safoankhan-rgb/nothing/01/docs/assets/01-light.png

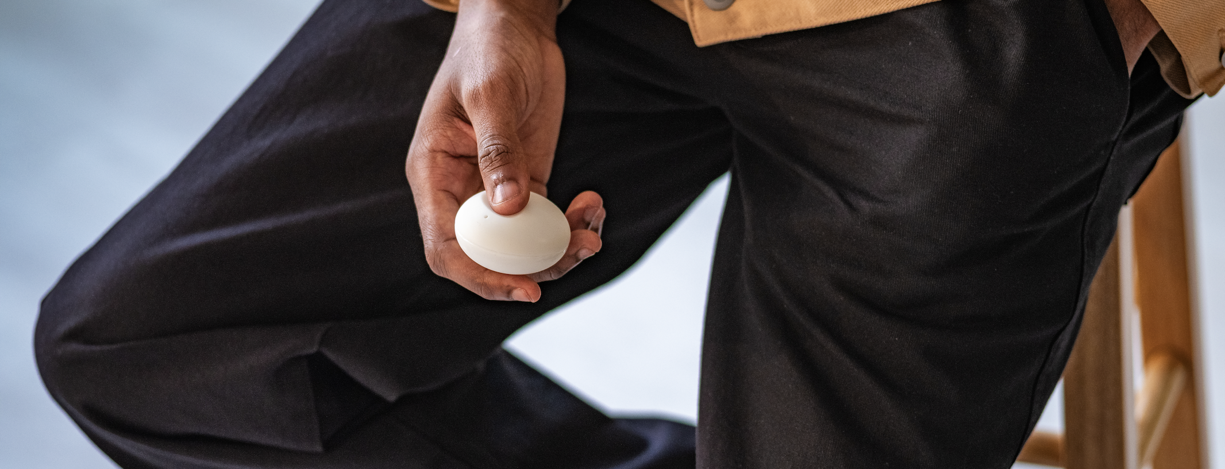
01/docs/assets/01-light.png
