safoankhan-rgb/nothing/01/docs/assets/app.png

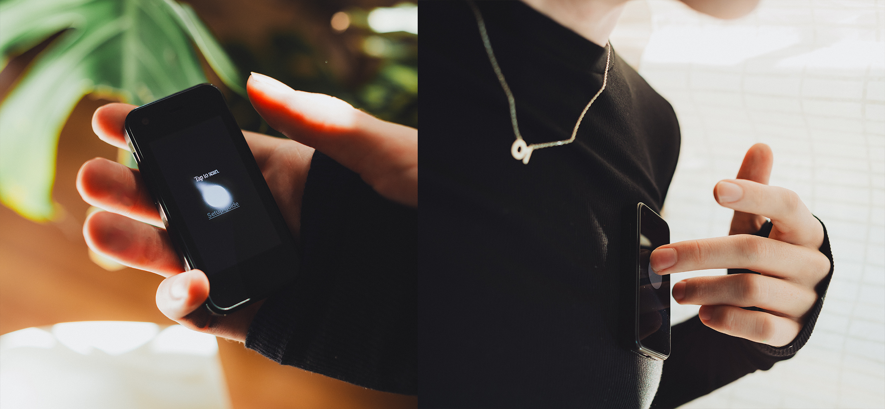
01/docs/assets/app.png
