safoankhan-rgb/nothing/01/docs/assets/AsyncTCP by dvarrel.png

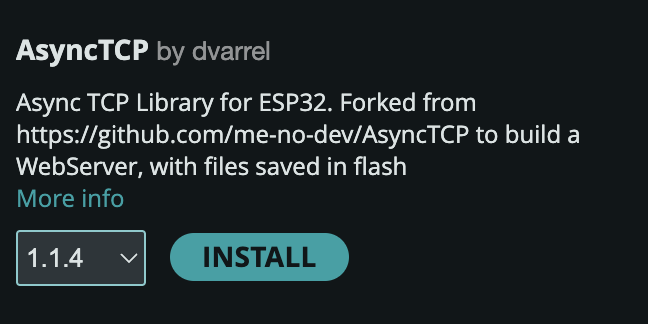
01/docs/assets/AsyncTCP by dvarrel.png
