safoankhan-rgb/nothing/01/docs/assets/boards-manager.png

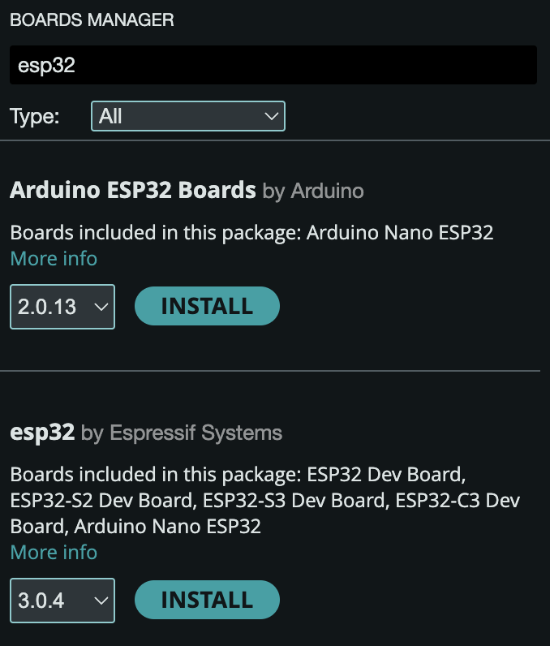
01/docs/assets/boards-manager.png
