safoankhan-rgb/nothing/01/docs/assets/connect_usb.jpeg

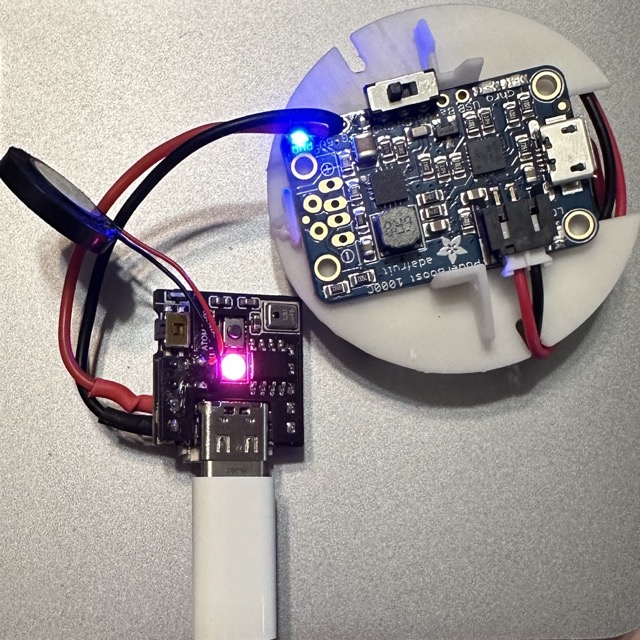
01/docs/assets/connect_usb.jpeg
