safoankhan-rgb/nothing/01/docs/assets/copy-client.png

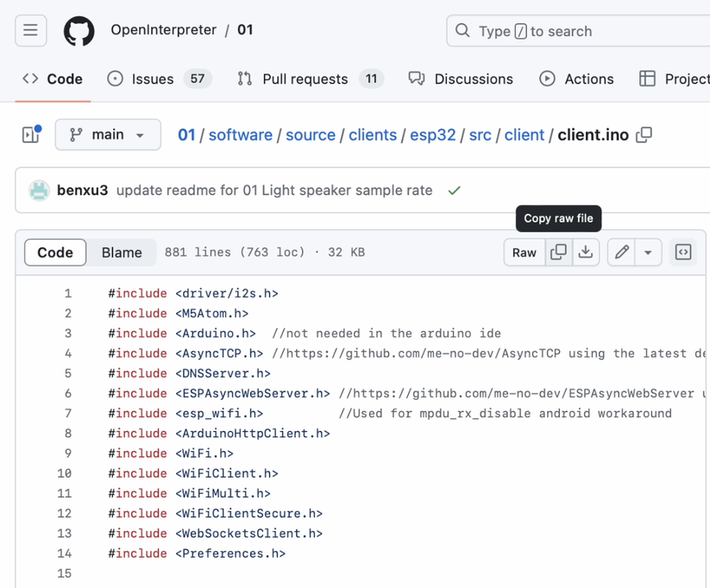
01/docs/assets/copy-client.png
