safoankhan-rgb/nothing/01/docs/assets/ESPAsyncWebServer by lacamera.png

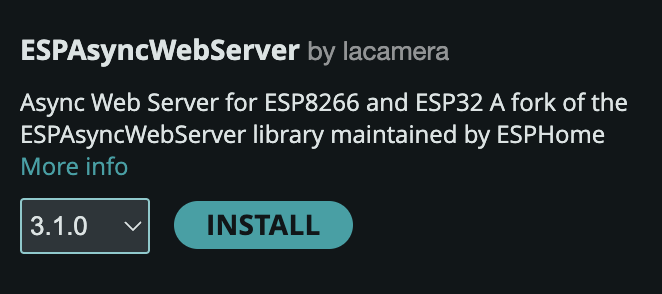
01/docs/assets/ESPAsyncWebServer by lacamera.png
