safoankhan-rgb/nothing/01/docs/assets/hardcode-wifi-pass-server.png

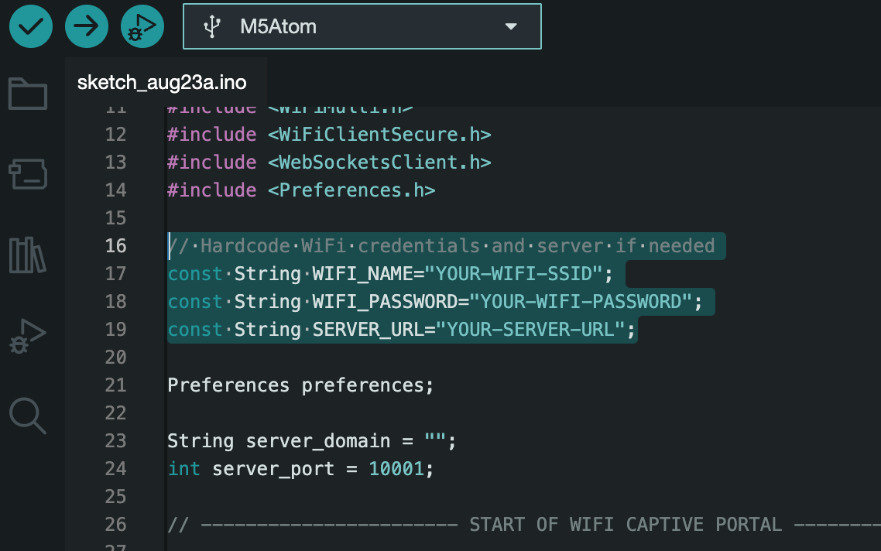
01/docs/assets/hardcode-wifi-pass-server.png
