safoankhan-rgb/nothing/01/docs/assets/M5-atom-library.png

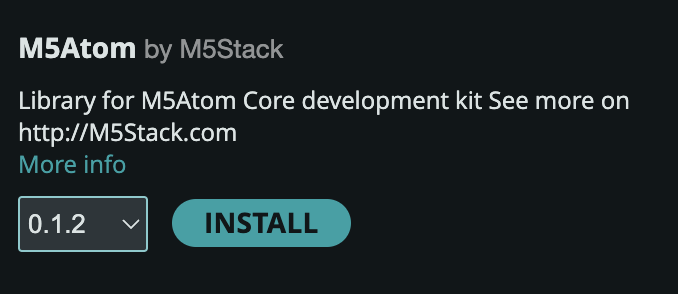
01/docs/assets/M5-atom-library.png
