safoankhan-rgb/nothing/01/docs/assets/m5atomecho.png

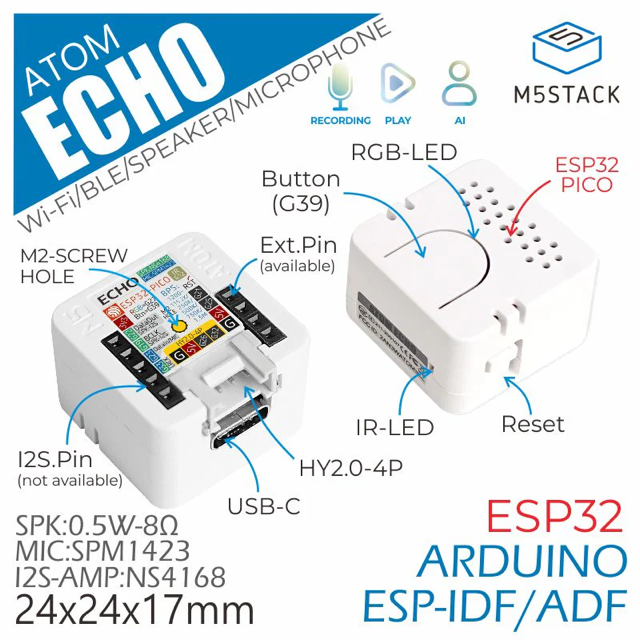
01/docs/assets/m5atomecho.png
