safoankhan-rgb/nothing/01/docs/assets/paste-client.png

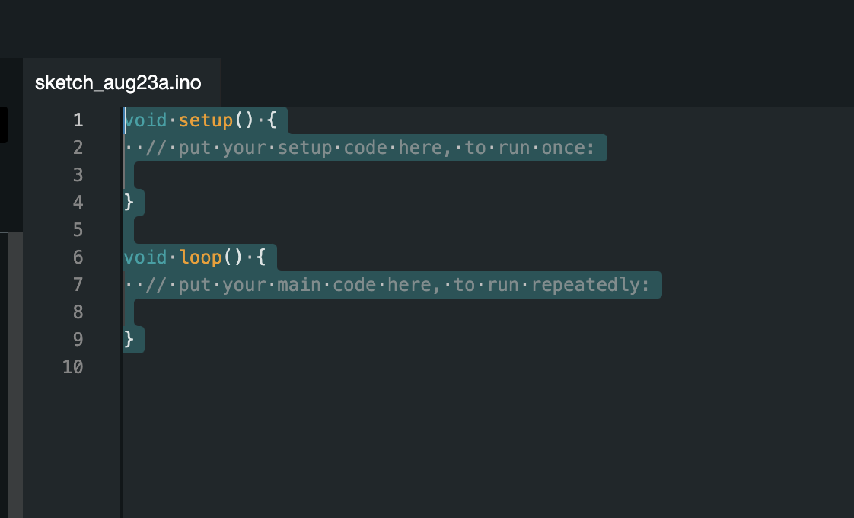
01/docs/assets/paste-client.png
