safoankhan-rgb/nothing/01/docs/assets/pasted-client.png

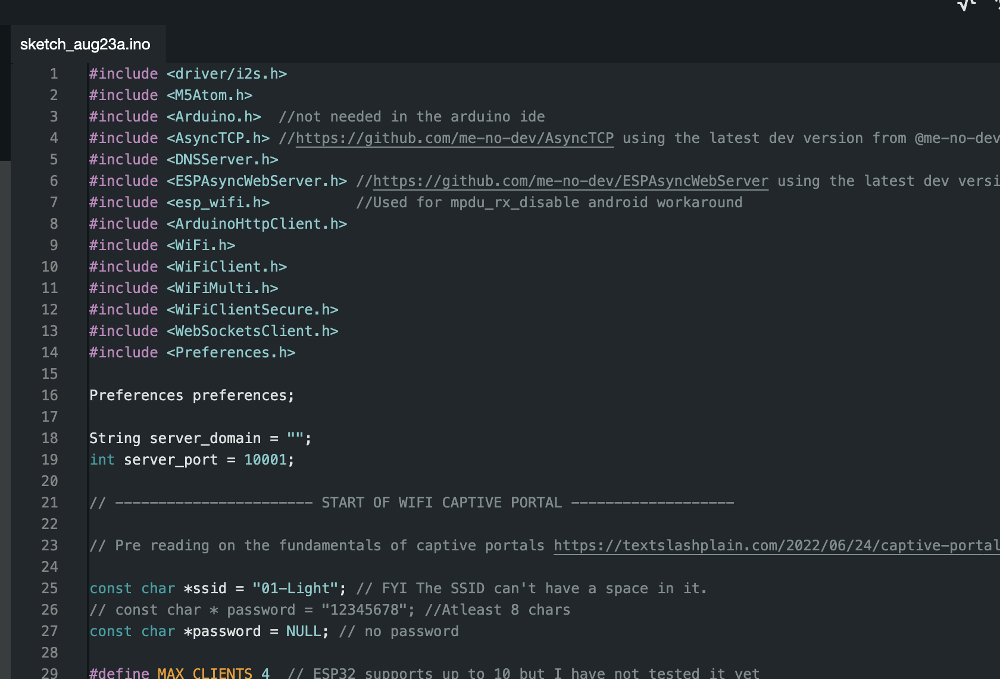
01/docs/assets/pasted-client.png
