safoankhan-rgb/nothing/01/docs/assets/Select Board and Port.png

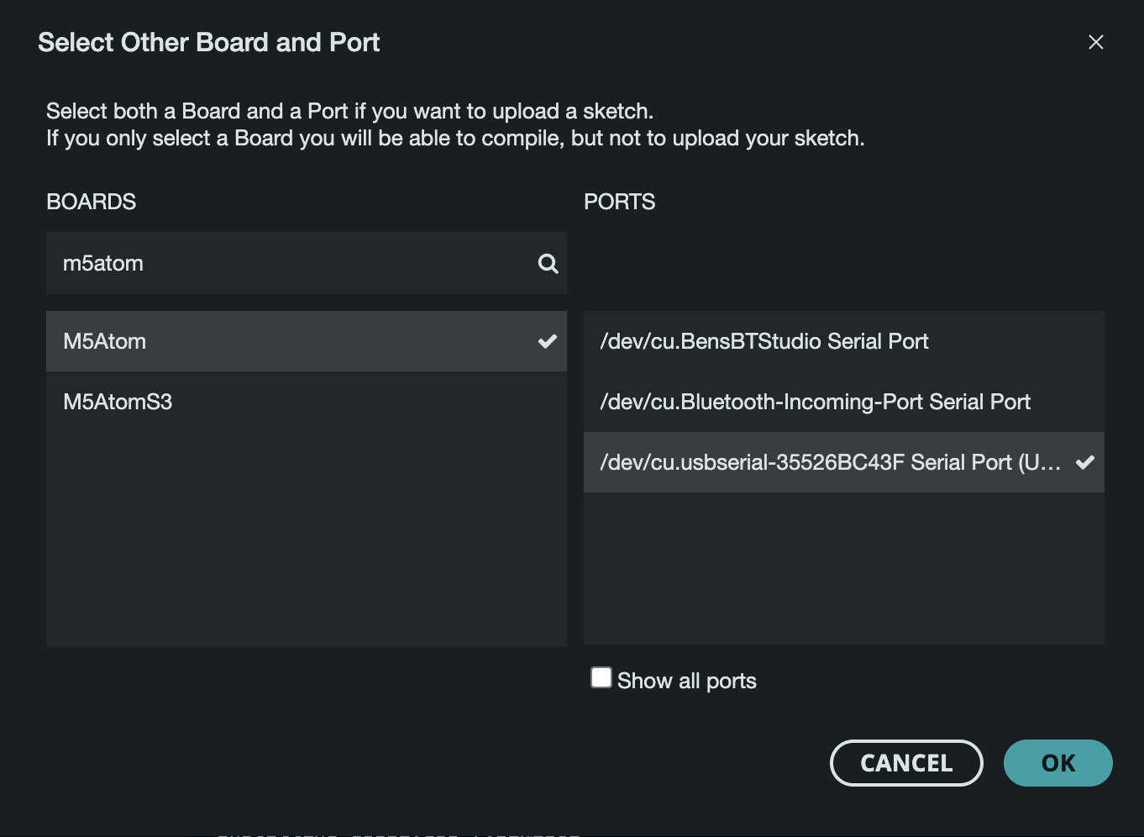
01/docs/assets/Select Board and Port.png
