safoankhan-rgb/nothing/01/docs/assets/Upload.png

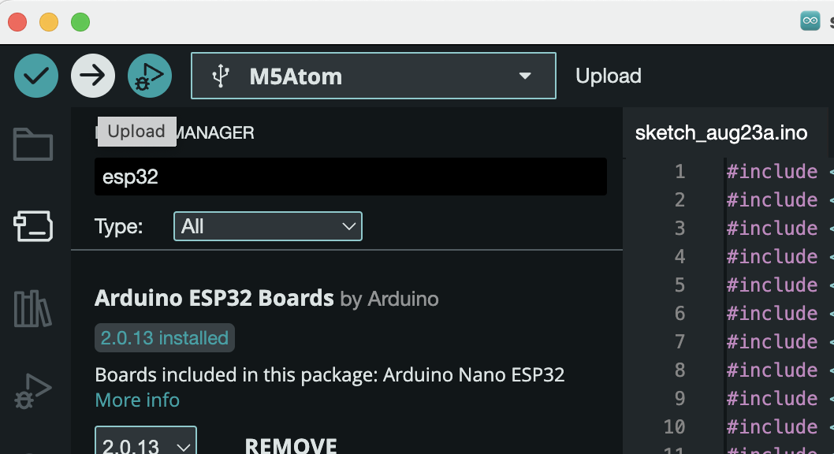
01/docs/assets/Upload.png
