safoankhan-rgb/nothing/01/docs/assets/WebSockets by Markus Sattler.png

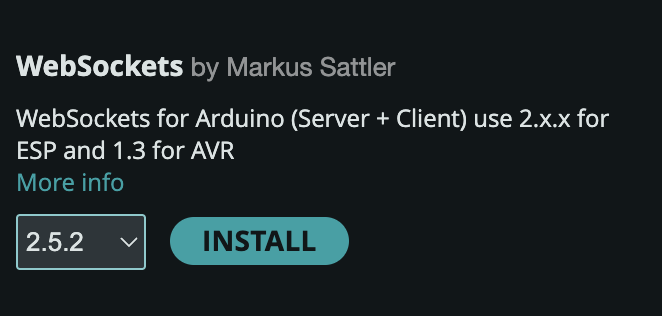
01/docs/assets/WebSockets by Markus Sattler.png
