safoankhan-rgb/nothing/01/hardware/light/bodies/v1.3/Backing Plate.stl

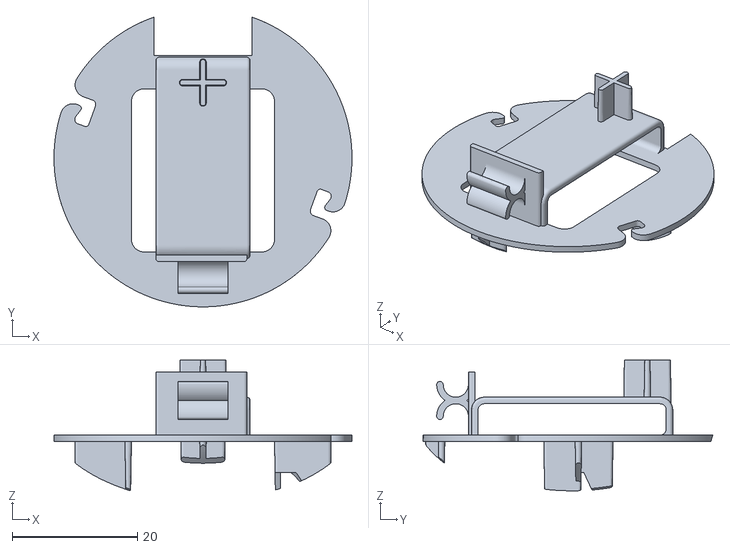
[picture p16: CAD file, 2026-09-18]
01/hardware/light/bodies/v1.3/Backing Plate.stl
47.5 x 46.2 x 20.8
