safoankhan-rgb/nothing/01/hardware/light/bodies/v0/01 Light v0 - Top.stl

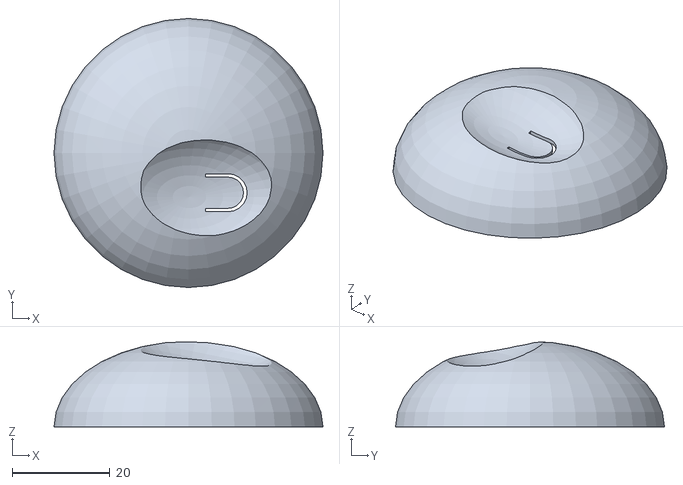
[picture p17: CAD file, 2026-09-18, an earlier design]
01/hardware/light/bodies/v0/01 Light v0 - Top.stl
55.0 x 55.0 x 17.4
