safoankhan-rgb/nothing/01/hardware/light/bodies/v1.2/Top Shell.stl

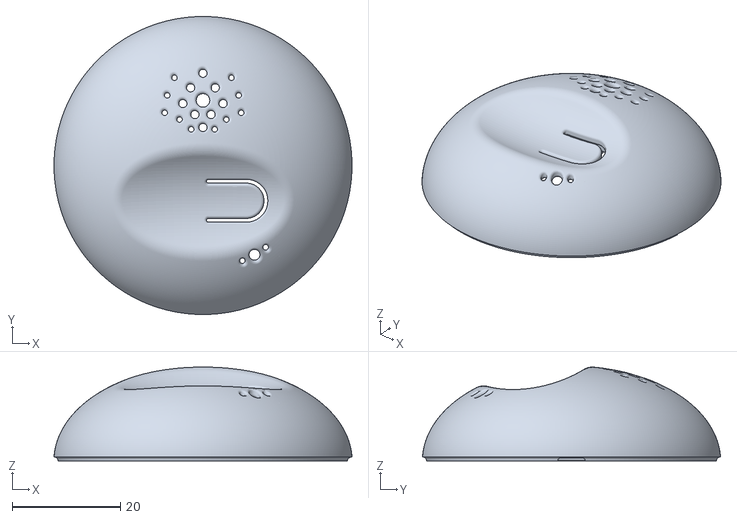
[picture p18: CAD file, 2026-09-18, an earlier design]
01/hardware/light/bodies/v1.2/Top Shell.stl
54.9 x 54.9 x 17.3
