safoankhan-rgb/nothing/01/hardware/light/bodies/v1.2/Bottom Shell.stl

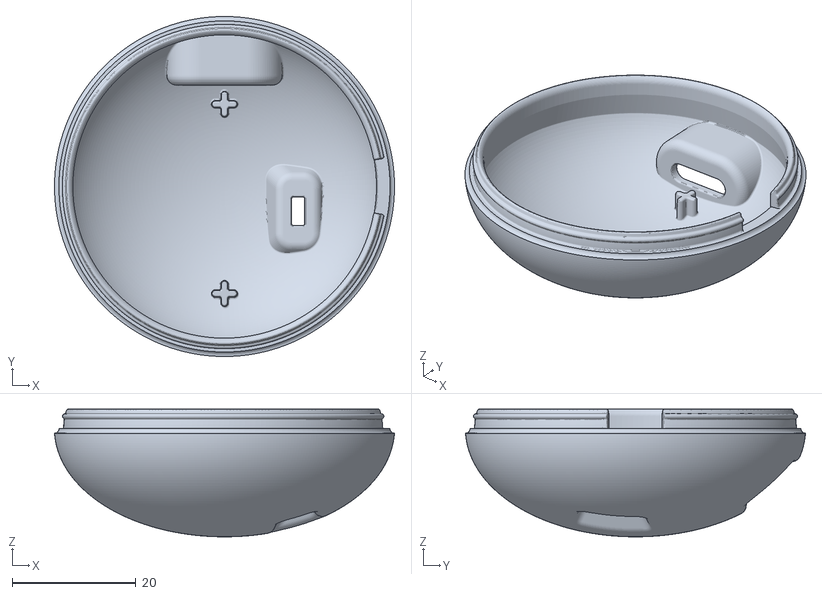
[picture p21: CAD file, 2026-09-18, an earlier design]
01/hardware/light/bodies/v1.2/Bottom Shell.stl
54.9 x 54.9 x 20.6
