safoankhan-rgb/nothing/01/hardware/light/bodies/v1/01 Light v1 - Bottom.STL

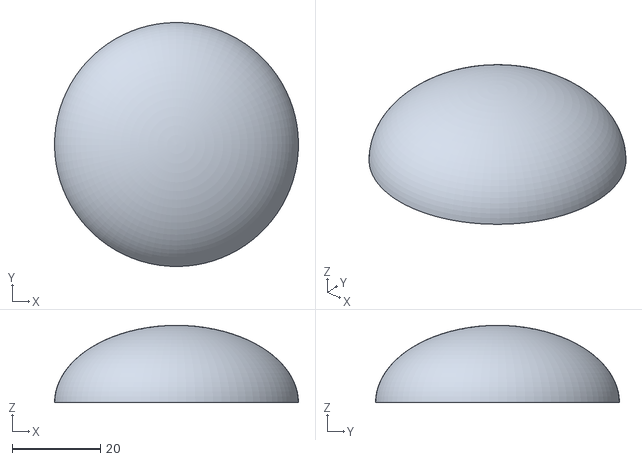
[picture p22: CAD file, 2026-09-18, an earlier design]
01/hardware/light/bodies/v1/01 Light v1 - Bottom.STL
55.2 x 55.2 x 17.5
