safoankhan-rgb/nothing/01/hardware/light/bodies/v1.2/Backing Plate.stl

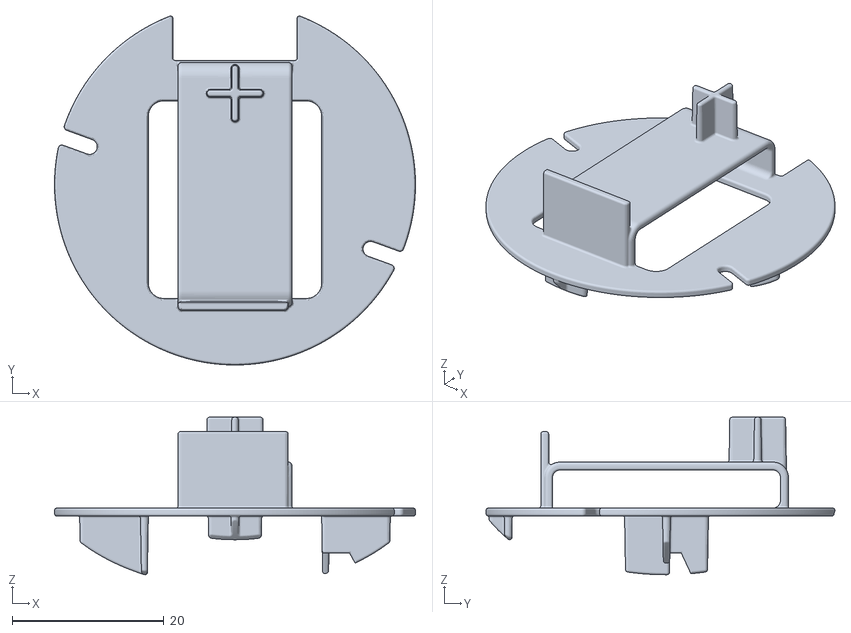
[picture p23: CAD file, 2026-09-18, an earlier design]
01/hardware/light/bodies/v1.2/Backing Plate.stl
47.5 x 45.9 x 20.7
