safoankhan-rgb/nothing/(list of files, cad)

Other CAD files:
01/hardware/light/bodies/v1.2/01, Test Housing v1.2.f3z
