safoankhan-rgb/nothing/01/docs/hardware/01-light/assembly.mdx

---
title: "Assembly"
description: "How to build your 01 Light"
---

Watch this video from James at CAD9 Design for a detailed guide on assembling your 01.

<iframe
  width="560"
  height="315"
  src="https://www.youtube.com/embed/37a5bgvoZy8"
  frameBorder="0"
  allow="accelerometer; autoplay; clipboard-write; encrypted-media; gyroscope; picture-in-picture"
  allowfullscreen
></iframe>

## Wiring Diagram

Wiring Diagram
