safoankhan-rgb/nothing/01/docs/assets/ESPAsyncWebServer-install-all.png

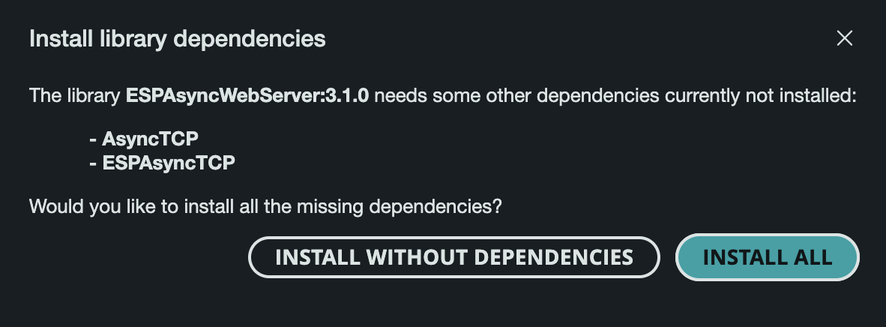
01/docs/assets/ESPAsyncWebServer-install-all.png
