safoankhan-rgb/nothing/01/docs/assets/m5-atom-install-all.png

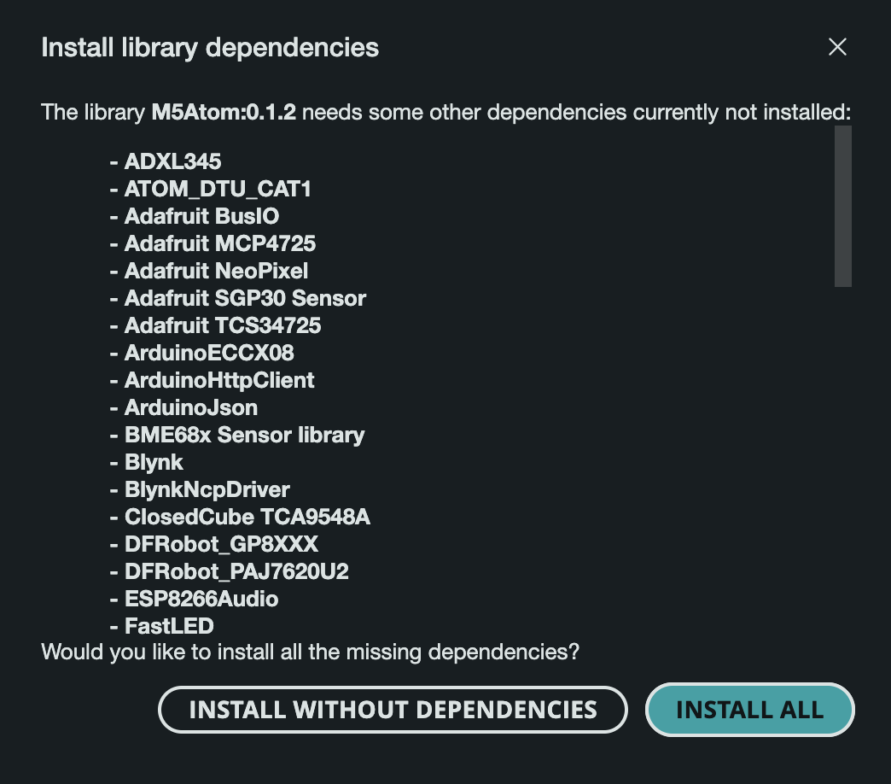
01/docs/assets/m5-atom-install-all.png
