safoankhan-rgb/nothing/01/hardware/light/Manufacturing Report/Assets/01_Light_PRD_Project_Details.png

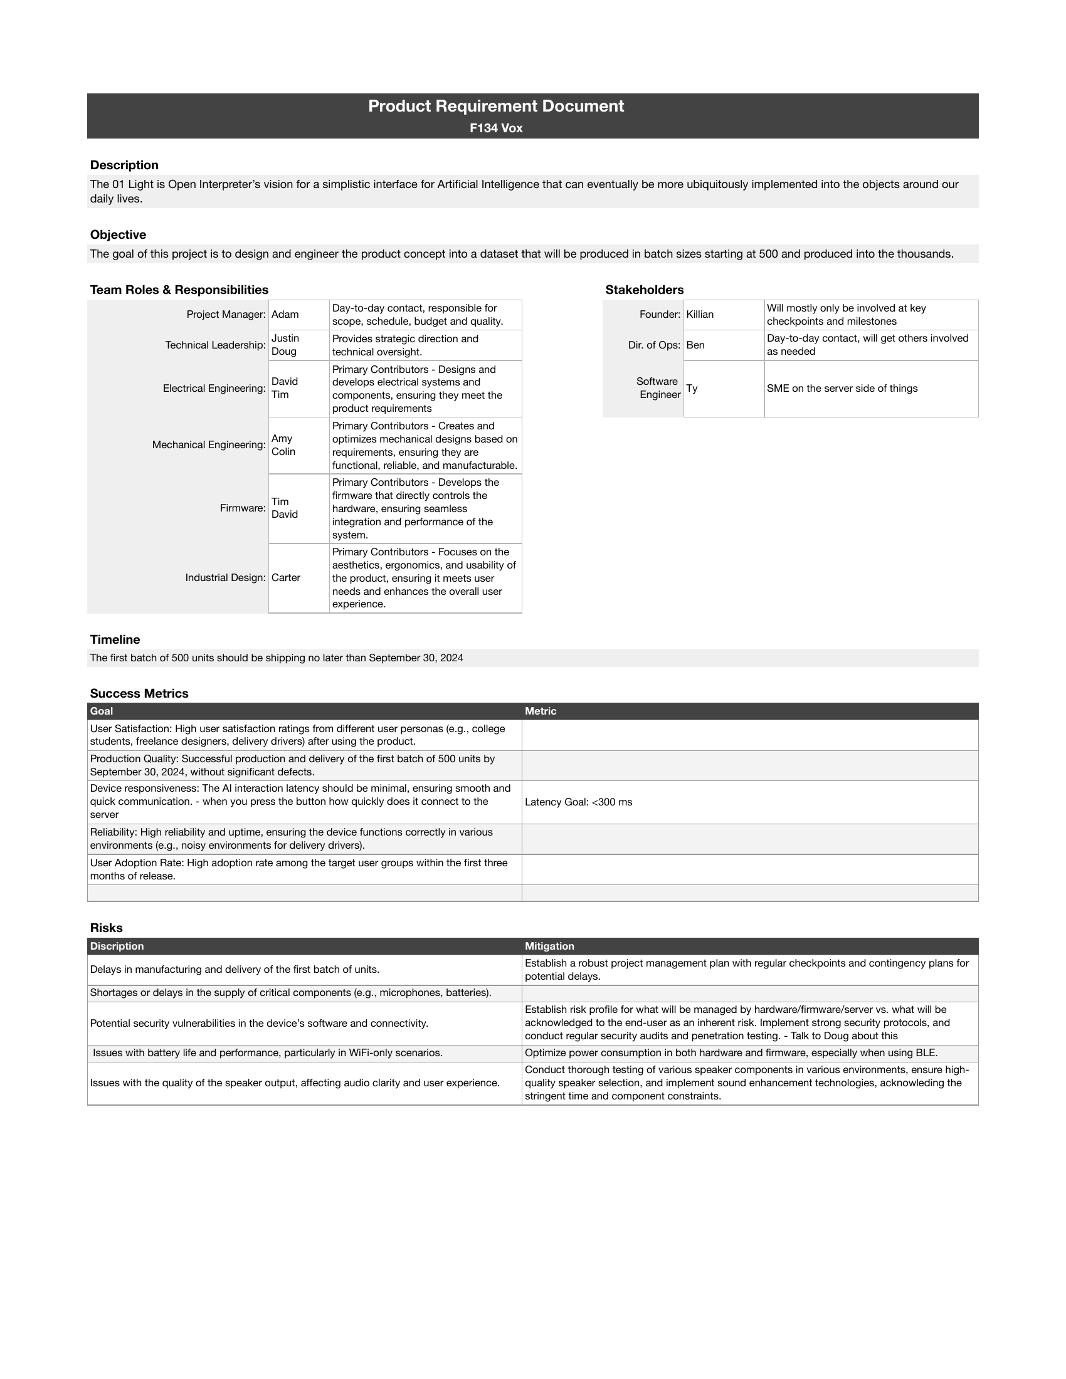
01/hardware/light/Manufacturing Report/Assets/01_Light_PRD_Project_Details.png
