safoankhan-rgb/nothing/01/hardware/light/wiring-diagram.png

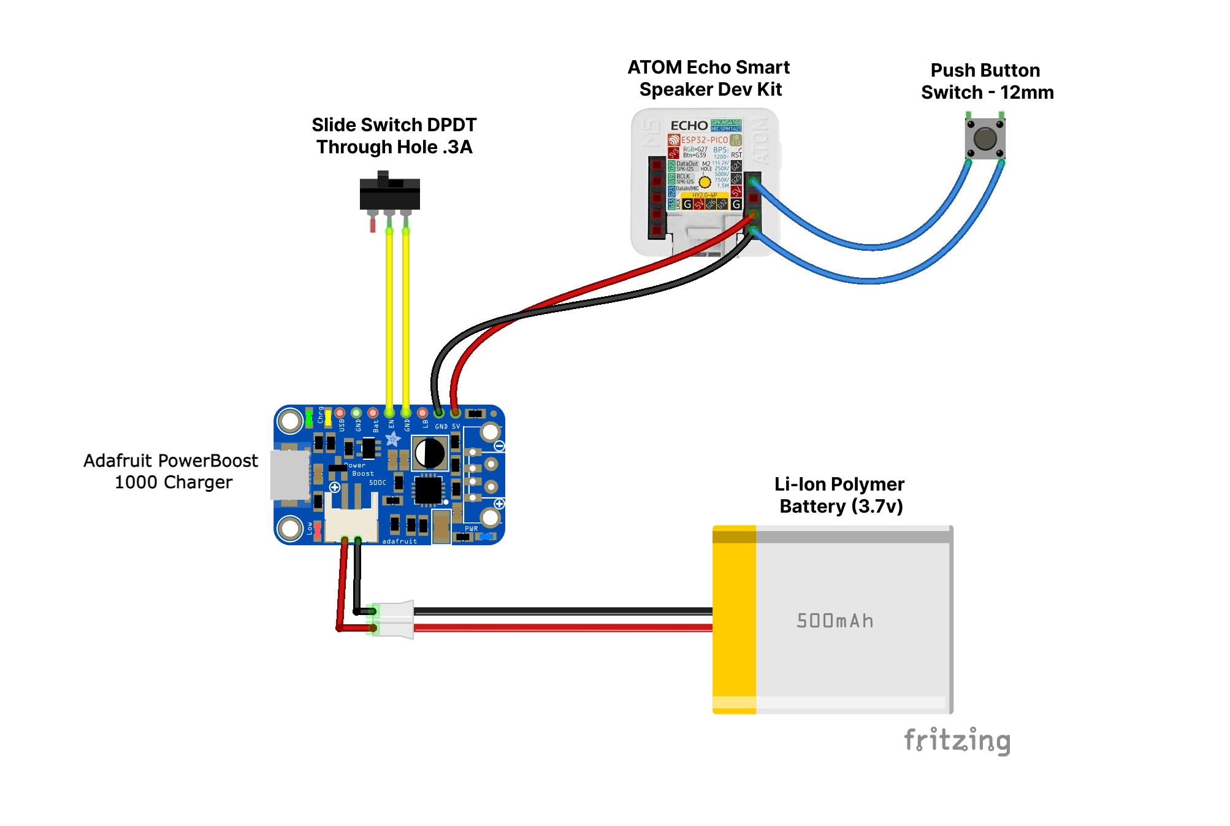
01/hardware/light/wiring-diagram.png
