safoankhan-rgb/nothing/(list of files, drawings)

Other design files:
01/hardware/light/O1Light - M5 ATOM Echo.fzz
